DylanBaut/Autonomous_Water_Skimmer/README.md

# Autonomous_Water_Skimmer
Senior Design Project 2024
