DylanBaut/Autonomous_Water_Skimmer/Turbidity readings/Turbidity Readings - DEMO 0 NTU F.V2.pdf

Turbidity Readings | DEMO 0 NTU F.V2
Sample ID | Average Voltage (V) | NTU
1 | 4.188 | 0
2 | 4.133 | 41.4
3 | 4.134 | 40.22
4 | 4.133 | 41.04
5 | 4.133 | 40.99
6 | 4.133 | 40.95
7 | 4.134 | 40.13
8 | 4.134 | 40.47
9 | 4.132 | 42.29
10 | 4.132 | 42.43
11 | 4.134 | 40.2
12 | 4.134 | 40.15
13 | 4.133 | 41.14
14 | 4.133 | 41.49
15 | 4.13 | 43.59
16 | 4.131 | 42.51
17 | 4.13 | 44.06
18 | 4.13 | 43.76
19 | 4.133 | 41.17
20 | 4.136 | 38.38
21 | 4.136 | 38.58
22 | 4.135 | 39.52
23 | 4.132 | 42.33
24 | 4.131 | 42.93
25 | 4.133 | 41.45
26 | 4.131 | 42.77
27 | 4.131 | 43.03
28 | 4.132 | 41.94
29 | 4.132 | 41.83

Sample ID | Average Voltage (V) | NTU
30 | 4.136 | 38.43
31 | 4.136 | 38.76
32 | 4.133 | 41.25
33 | 4.133 | 40.84
34 | 4.135 | 39.67
35 | 4.135 | 39.28
36 | 4.134 | 40.37
37 | 4.134 | 40.62
38 | 4.133 | 41.03
39 | 4.133 | 41.49
40 | 4.133 | 41.19
41 | 4.132 | 41.99
42 | 4.132 | 42.27
43 | 4.133 | 41.23
44 | 4.134 | 40.37
45 | 4.134 | 40.7
46 | 4.135 | 39.48
47 | 4.135 | 39.23
48 | 4.135 | 39.86
49 | 4.134 | 40.16
50 | 4.134 | 40.19
51 | 4.134 | 40.04
52 | 4.133 | 41.36
53 | 4.133 | 41.14
54 | 4.135 | 39.97
55 | 4.134 | 40.47
56 | 4.134 | 40.51
57 | 4.133 | 41.1
58 | 4.132 | 41.82

Sample ID | Average Voltage (V) | NTU
59 | 4.136 | 38.87
60 | 4.134 | 40.14
In ±10NTU Range | Range | Range
Not In ±10NTU Range | 4.130 to 4.136 | 38.38 to 44.06
