DylanBaut/Autonomous_Water_Skimmer/Turbidity readings/Turbidity Readings - DEMO 100 NTU F.V2.pdf

Turbidity Readings | | DEMO 100 NTU F.V2
Sample ID | Average Voltage (V) | NTU
1 | 4.012 | 142.12
2 | 4.015 | 139.89
3 | 4.01 | 144.15
4 | 4.005 | 147.74
5 | 4.004 | 148.65
6 | 4.008 | 145.46
7 | 4.019 | 136.22
8 | 4.009 | 144.4
9 | 4.012 | 141.85
10 | 4.013 | 141.3
11 | 4.008 | 145.12
12 | 4.011 | 142.95
13 | 4.007 | 146.27
14 | 4.016 | 138.69
15 | 4.015 | 139.06
16 | 4.014 | 140.6
17 | 4.02 | 135.04
18 | 4.012 | 142.12
19 | 4.015 | 139.89
20 | 4.01 | 144.15
21 | 4.005 | 147.74
22 | 4.004 | 148.65
23 | 4.008 | 145.46
24 | 4.019 | 136.22
25 | 4.009 | 144.4
26 | 4.012 | 141.85
27 | 4.013 | 141.3
28 | 4.008 | 145.12
29 | 4.011 | 142.95

Sample ID | Average Voltage (V) | NTU
30 | 4.007 | 146.27
31 | 4.016 | 138.69
32 | 4.015 | 139.06
33 | 4.014 | 140.6
34 | 4.02 | 135.04
35 | 4.012 | 142.12
36 | 4.015 | 139.89
37 | 4.01 | 144.15
38 | 4.005 | 147.74
39 | 4.004 | 148.65
40 | 4.008 | 145.46
41 | 4.019 | 136.22
42 | 4.009 | 144.4
43 | 4.012 | 141.85
44 | 4.013 | 141.3
45 | 4.008 | 145.12
46 | 4.011 | 142.95
47 | 4.007 | 146.27
48 | 4.016 | 138.69
49 | 4.015 | 139.06
50 | 4.014 | 140.6
51 | 4.02 | 135.04
52 | 4.012 | 142.12
53 | 4.015 | 139.89
54 | 4.01 | 144.15
55 | 4.005 | 147.74
56 | 4.004 | 148.65
57 | 4.008 | 145.46
58 | 4.019 | 136.22

Sample ID | Average Voltage (V) | NTU
59 | 4.009 | 144.4
60 | 4.012 | 141.85
In ±10NTU Range | Range | Range
Not In ±10NTU Range | 4.004 to 4.020 | 135.04 to 148.65
