DylanBaut/Autonomous_Water_Skimmer/Turbidity readings/Turbidity Readings - DEMO 25 NTU F.V2.pdf

Turbidity Readings | | DEMO 25 NTU F.V2
Sample ID | Average Voltage (V) | NTU
1 | 4.11 | 60.66
2 | 4.107 | 63.07
3 | 4.107 | 63.2
4 | 4.107 | 62.63
5 | 4.109 | 61.17
6 | 4.107 | 63.2
7 | 4.105 | 64.53
8 | 4.106 | 63.92
9 | 4.106 | 63.41
10 | 4.104 | 65.02
11 | 4.104 | 65.33
12 | 4.105 | 64.81
13 | 4.105 | 64.83
14 | 4.107 | 63.32
15 | 4.105 | 64.25
16 | 4.106 | 63.54
17 | 4.106 | 63.86
18 | 4.102 | 66.96
19 | 4.105 | 64.61
20 | 4.104 | 65.48
21 | 4.102 | 67.31
22 | 4.104 | 65.75
23 | 4.103 | 66.02
24 | 4.103 | 66.28
25 | 4.104 | 65.31
26 | 4.104 | 65.1
27 | 4.105 | 64.32
28 | 4.104 | 65.06
29 | 4.105 | 64.4

Sample ID | Average Voltage (V) | NTU
30 | 4.106 | 63.88
31 | 4.105 | 64.25
32 | 4.108 | 62.14
33 | 4.107 | 62.71
34 | 4.11 | 60.41
35 | 4.109 | 61.14
36 | 4.108 | 61.8
37 | 4.108 | 62.03
38 | 4.105 | 64.86
39 | 4.105 | 64.54
40 | 4.104 | 65.07
41 | 4.109 | 61.58
42 | 4.107 | 62.87
43 | 4.108 | 62.2
44 | 4.104 | 65.14
45 | 4.104 | 65.07
46 | 4.105 | 64.94
47 | 4.104 | 65.42
48 | 4.105 | 64.92
49 | 4.105 | 64.38
50 | 4.102 | 66.77
51 | 4.103 | 65.86
52 | 4.106 | 64.13
53 | 4.104 | 65.22
54 | 4.105 | 64.24
55 | 4.107 | 63.23
56 | 4.106 | 64.04
57 | 4.106 | 63.51
58 | 4.109 | 61.1

Sample ID | Average Voltage (V) | NTU
59 | 4.111 | 59.98
60 | 4.11 | 60.79
In ±10NTU Range | Range | Range
Not In ±10NTU Range | 4.102 to 4.111 | 59.98 to 67.31
