DylanBaut/Autonomous_Water_Skimmer/Turbidity readings/Turbidity Readings - DEMO 50 NTU F.V2.pdf

Turbidity Readings | | DEMO 50 NTU F.V2
Sample ID | Average Voltage (V) | NTU
1 | 4.077 | 87.66
2 | 4.08 | 85.8
3 | 4.071 | 92.57
4 | 4.066 | 97.21
5 | 4.065 | 97.58
6 | 4.072 | 92.1
7 | 4.075 | 89.52
8 | 4.078 | 86.86
9 | 4.078 | 87.24
10 | 4.071 | 92.82
11 | 4.068 | 95.28
12 | 4.065 | 98.03
13 | 4.066 | 96.68
14 | 4.07 | 93.6
15 | 4.07 | 93.62
16 | 4.067 | 95.84
17 | 4.07 | 93.37
18 | 4.071 | 93.08
19 | 4.067 | 96.03
20 | 4.065 | 97.94
21 | 4.068 | 95.46
22 | 4.072 | 92.47
23 | 4.078 | 87.18
24 | 4.072 | 91.83
25 | 4.063 | 99.92
26 | 4.067 | 96.36
27 | 4.064 | 98.73
28 | 4.06 | 101.8
29 | 4.066 | 97.39

Sample ID | Average Voltage (V) | NTU
30 | 4.068 | 95.69
31 | 4.064 | 98.53
32 | 4.065 | 97.86
33 | 4.067 | 96.36
34 | 4.064 | 98.73
35 | 4.061 | 101.12
36 | 4.066 | 96.95
37 | 4.067 | 96.19
38 | 4.065 | 98.15
39 | 4.06 | 101.78
40 | 4.063 | 99.59
41 | 4.071 | 92.62
42 | 4.064 | 98.62
43 | 4.065 | 97.97
44 | 4.065 | 98.2
45 | 4.068 | 95.77
46 | 4.066 | 96.75
47 | 4.064 | 98.87
48 | 4.061 | 101
49 | 4.062 | 100.63
50 | 4.067 | 96
51 | 4.076 | 88.67
52 | 4.077 | 87.81
53 | 4.074 | 90.74
54 | 4.07 | 93.97
55 | 4.068 | 95.5
56 | 4.075 | 89.87
57 | 4.079 | 86.52
58 | 4.068 | 95.16

Sample ID | Average Voltage (V) | NTU
59 | 4.066 | 97.05
60 | 4.069 | 94.58
In ±10NTU Range | Range | Range
Not In ±10NTU Range | 4.060 to 4.080 | 85.80 to 101.80
