DylanBaut/Autonomous_Water_Skimmer/public/pics/jellyfishbot.jpeg

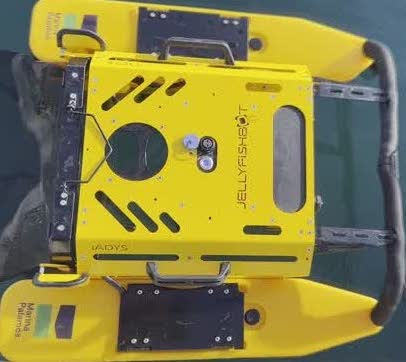
public/pics/jellyfishbot.jpeg
