DylanBaut/Autonomous_Water_Skimmer/public/pics/lake.jpg

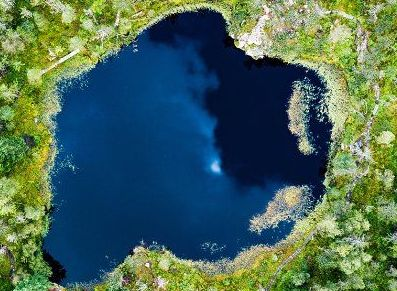
public/pics/lake.jpg
