DylanBaut/Autonomous_Water_Skimmer/(commit log)

2024-12-01 working prototype simulation
2024-12-03 Turbidity Data
    The "DEMO # NTU" shows the data that was taken after calibrating the turbidity equations with the "# NTU" data.
2024-12-13 Add files via upload
    sensor pictures
